Hung-Chi970104/nrf24l01-radio/radio.kicad_pcb

## KiCad design radio.kicad_pcb (2026-09-16)

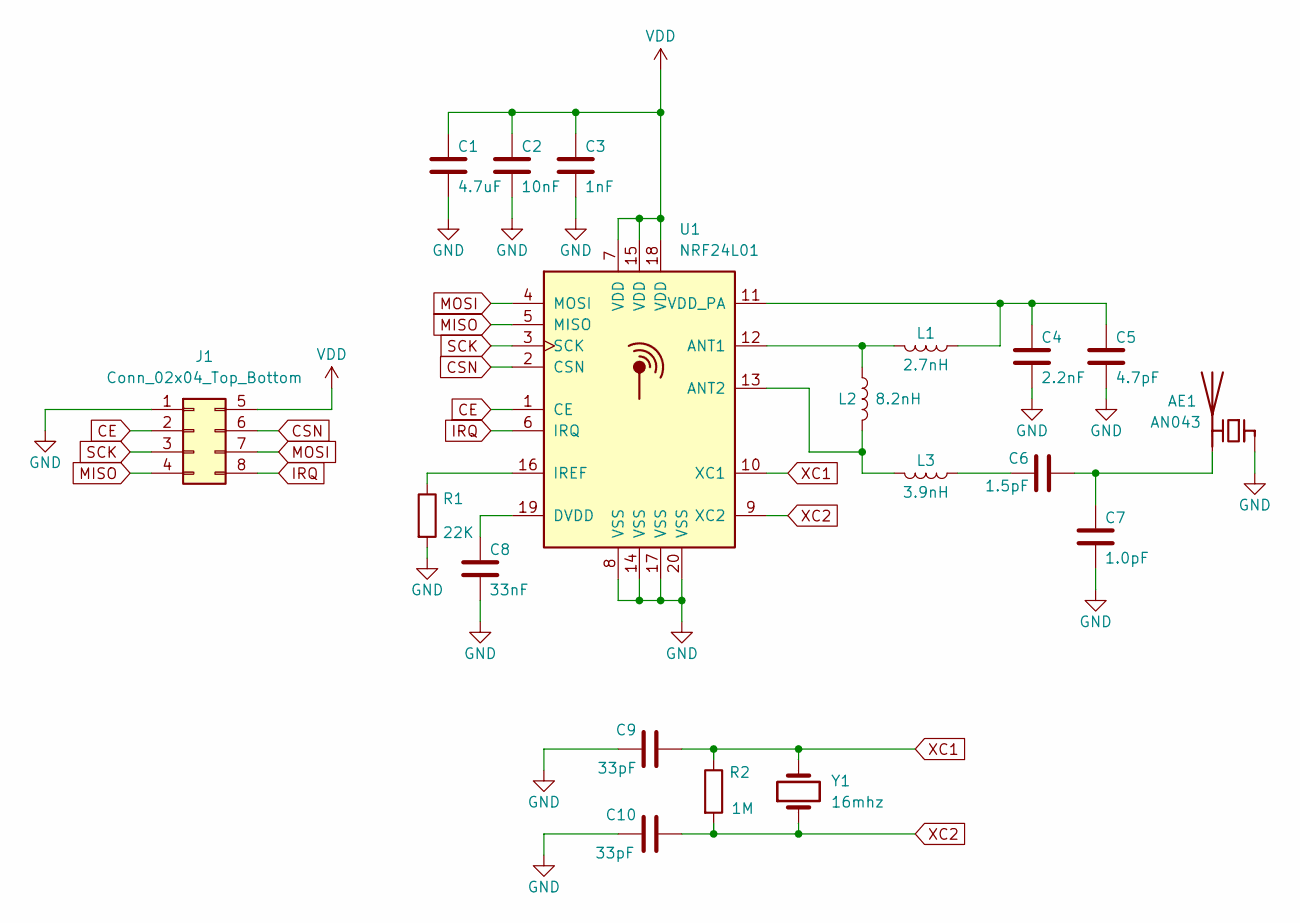
[picture p3: schematic radio.kicad_sch]

Parts:
AE1: AN043
C1: 4.7uF; C_0402_1005Metric
C2: 10nF; C_0402_1005Metric
C3: 1nF; C_0402_1005Metric
C4: 2.2nF; C_0402_1005Metric
C5: 4.7pF; C_0402_1005Metric
C6: 1.5pF; C_0402_1005Metric
C7: 1.0pF; C_0402_1005Metric
C8: 33nF; C_0402_1005Metric
C9, C10: 33pF; C_0402_1005Metric
J1: Conn_02x04_Top_Bottom; PinHeader_2x04_P2.54mm_Vertical
L1: 2.7nH; L_0402_1005Metric
L2: 8.2nH; L_0402_1005Metric
L3: 3.9nH; L_0402_1005Metric
R1: 22K; R_0402_1005Metric
R2: 1M; R_0402_1005Metric
U1: NRF24L01; QFN-20-1EP_4x4mm_P0.5mm_EP2.5x2.5mm
Y1: 16mhz; Crystal_HC49-4H_Vertical

Connections:
CE: J1.2, U1.1 (CE)
CSN: J1.6, U1.2 (CSN)
GND: AE1.1 (FEED), C1.2, C2.2, C3.2, C4.2, C5.2, C7.2, C8.2, C9.1, C10.1, J1.1, R1.2, U1.8 (VSS), U1.14 (VSS), U1.17 (VSS), U1.20 (VSS)
IRQ: J1.8, U1.6 (IRQ)
MISO: J1.4, U1.5 (MISO)
MOSI: J1.7, U1.4 (MOSI)
unnamed: AE1.2 (PCB_Trace), C6.2, C7.1
unnamed: C6.1, L3.1
unnamed: L1.2, L2.1, U1.12 (ANT1)
unnamed: L2.2, L3.2, U1.13 (ANT2)
unnamed: C8.1, U1.19 (DVDD)
unnamed: R1.1, U1.16 (IREF)
unnamed: C4.1, C5.1, L1.1, U1.11 (VDD_PA)
SCK: J1.3, U1.3 (SCK)
VDD: C1.1, C2.1, C3.1, J1.5, U1.7 (VDD), U1.15 (VDD), U1.18 (VDD)
XC1: C9.2, R2.1, U1.10 (XC1), Y1.2
XC2: C10.2, R2.2, U1.9 (XC2), Y1.1

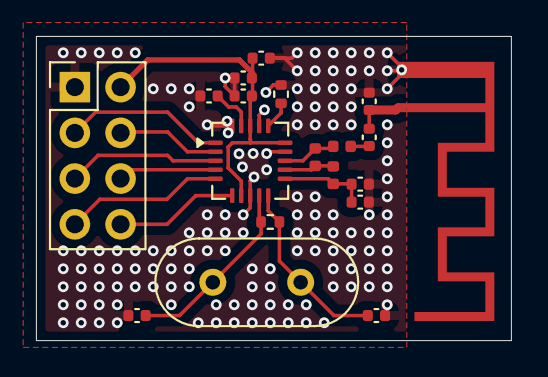
[picture p4: board radio.kicad_pcb from above]

Board: 2 copper layers, 26.4 x 16.9 mm, 19 parts (0 on the bottom side), 17 nets.
